endsummercamp/minibadge/docs/README.md

## Documentation of the minibadge ESC 2024

This documentation is written in LaTeX, with the Free Software editor TeXstudio.

### Quick start with Debian

In Debian, stay ready to download tons of nonsense fonts:

```
sudo apt install texstudio texlive-fonts-extra-links texlive-latex-extra
```
