endsummercamp/minibadge/antani_hw/README.md

# End Summer Camp - Mini Badge - Hardware

This is the hardware design for the End Summer Camp Mini Badge.

The project is designed in KiCad.
