endsummercamp/minibadge/(threads)

Thread 2 (2024-09-18):

New Light Effect: Shutdown Lights

valerio-bozzolan, 2024-09-18:
It's probably useful to use the badge as infrared receiver and nothing else.

But at the moment it seems not possible to me to switch off all lights.

Kezii, 2024-09-18:
fixed in 0b926283993565bb809acc2fe4b74b2bf162e697

Closed 2024-09-18.
