endsummercamp/minibadge/(commit log)

2024-08-04 più o meno fatto
    [antani_hw.kicad_pcb, antani_hw.kicad_sch, usb.kicad_sch]
2024-08-06 rp2040 su sottoscherma, layout rivisto
    [antani_hw.kicad_pcb, antani_hw.kicad_sch, rp2040.kicad_sch]
2024-08-21 define pins, blink ir led
2024-08-22 [hardware] move led expansion header away from led footprint
    [antani_hw.kicad_pcb]
2024-08-22 [hardware] add jlc tooling holes
    [antani_hw.kicad_pcb, antani_hw.kicad_sch]
2024-08-22 [hardware] small layout change
    [antani_hw.kicad_pcb]
2024-08-23 [hardware] move ir sensor to gpio 9 (uart1 rx)
    [antani_hw.kicad_pcb, antani_hw.kicad_sch]
2024-08-23 [hardware] move tag-connect so it's not under a component on the other side, add white led
    [antani_hw.kicad_pcb, antani_hw.kicad_sch]
2024-08-23 [hardware] enlarge led footprint pads so it's easier to handsolder
    [antani_hw.kicad_pcb, antani_hw.kicad_sch]
2024-08-25 [software] button driver, select effect and power with button, gamma correction
    [main.rs]
2024-08-25 [software] split gains before and after gamma correction
    [main.rs]
2024-08-25 [software] render override for button feedback effects
2024-08-25 [software] when starting with the user button pressed, function as a torchlight
2024-08-25 [software] add 🚨 police light effect (blue-red american style)
2024-08-26 [software] ir command to reset / syncronize clocks
    [main.rs]
2024-08-26 [hardware] rotate ir led, dnp header, move tooling hole
    [antani_hw.kicad_pcb, antani_hw.kicad_sch]
2024-08-26 [hardware] bridge ir sensor to gpio 9 and 10
    [antani_hw.kicad_pcb, antani_hw.kicad_sch]
2024-08-27 [software] 2d rainbow, move scenes to a separate file, generic framebuffer
2024-08-27 [software] fix gamma correction bug for screen shader, use renderman persistent data to avoid mutex in lowpass, add rgb glitter effect
    [main.rs, rgbeffects.rs, scenes.rs]
2024-08-28 [software] expose the minibadge as an usb midi device, control colors with midi events
2024-08-29 [software] implement ir blaster, show boot animation / greet when nearby badges power on
2024-08-30 [software] force ir led to stay off when pwm is disabled
2024-08-30 [software] replace main queue, ir queue and hlcommand with a single global pub/sub channel
    [main.rs, usb.rs]
2024-08-31 [software] remove unwrap from adc and midi
2024-09-05 [hardware] lcsc code for rgb leds, remove dnp for rgb leds, give name to expansion pads
    [antani_hw.kicad_pcb, antani_hw.kicad_sch]
2024-09-05 [hardware] add all 3d models
    [antani_hw.kicad_pcb]
2024-09-06 [software] white led task / blink on error and communication
    [main.rs, usb.rs]
2024-09-06 [software] pr got merged, switch back to mainline embassy
2024-09-06 [software] run mainloop / graphics on core 1. do not block queue on white led task
2024-09-09 [software] implement transparent support for rgbw leds (ditch RGB8, use own type for color)
2024-09-18 [software] add leds off scene
2024-09-20 minibadge-cli - renaming the module correctly.
    [build.rs, main.rs, midi.rs]
2024-10-04 [firmware] add 3x3 font, alphabet and "ESC" scene
